Arbalest-Rocketry/flight-computer/__src__/apogee_detector/apogee/Screenshot (225).png

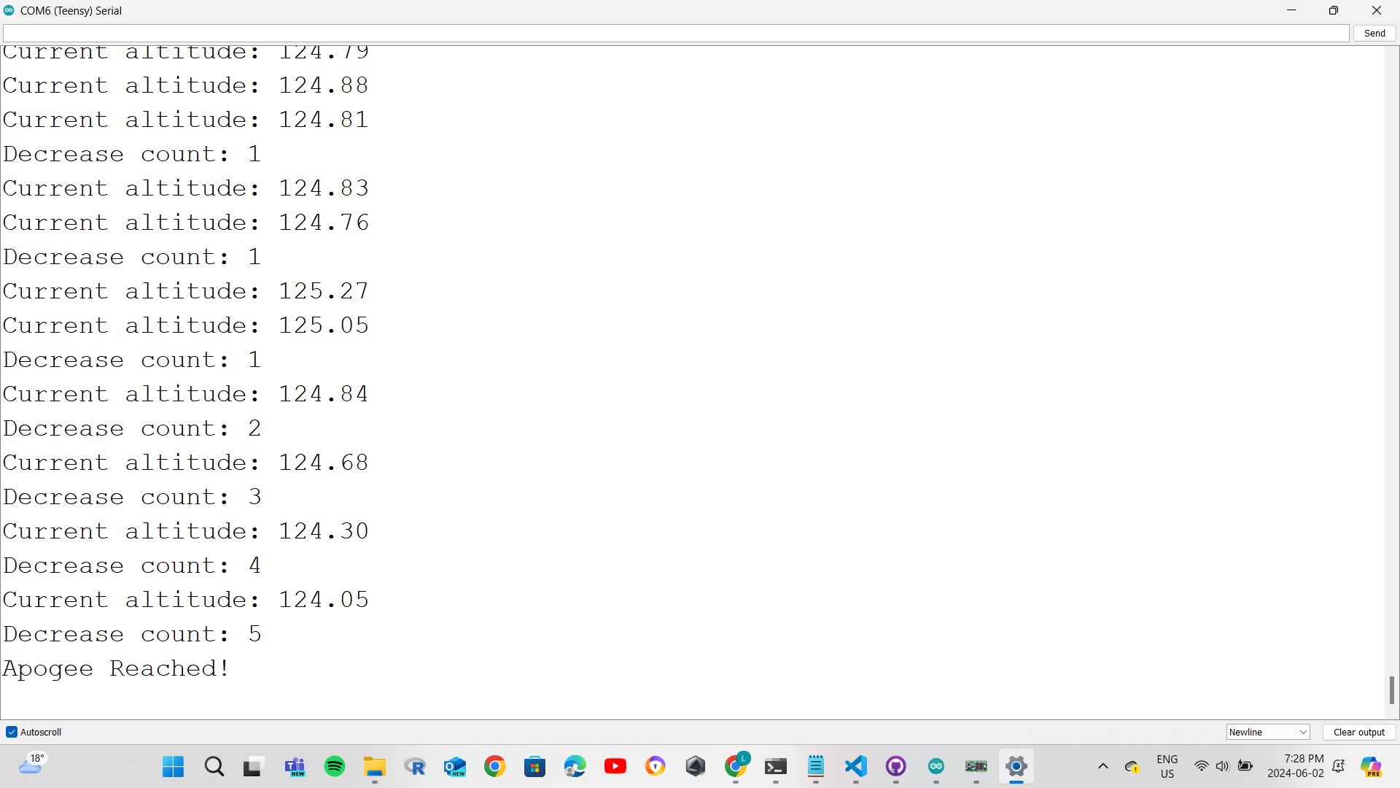
__src__/apogee_detector/apogee/Screenshot (225).png
