Arbalest-Rocketry/flight-computer/images/Electronics_mount_housing.png

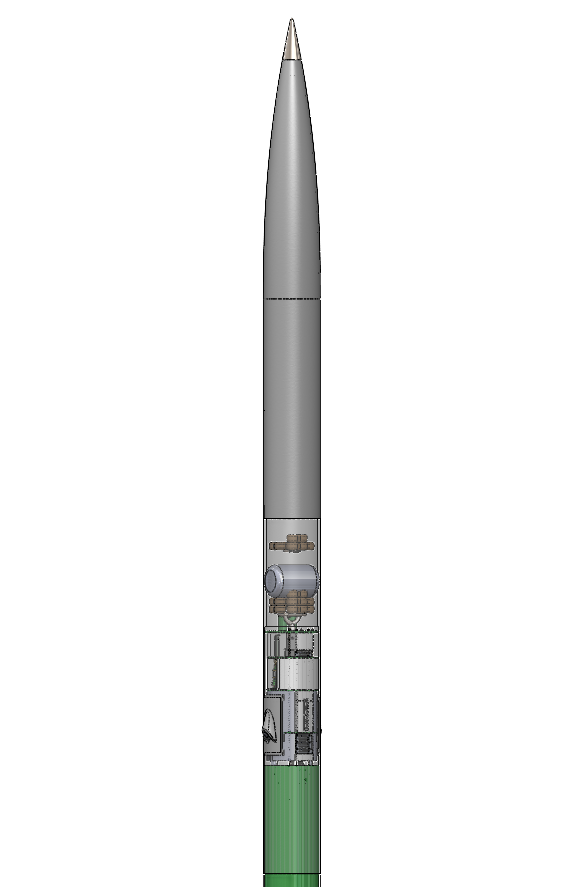
images/Electronics_mount_housing.png
