Arbalest-Rocketry/flight-computer/images/gems/20240319_135958.jpg

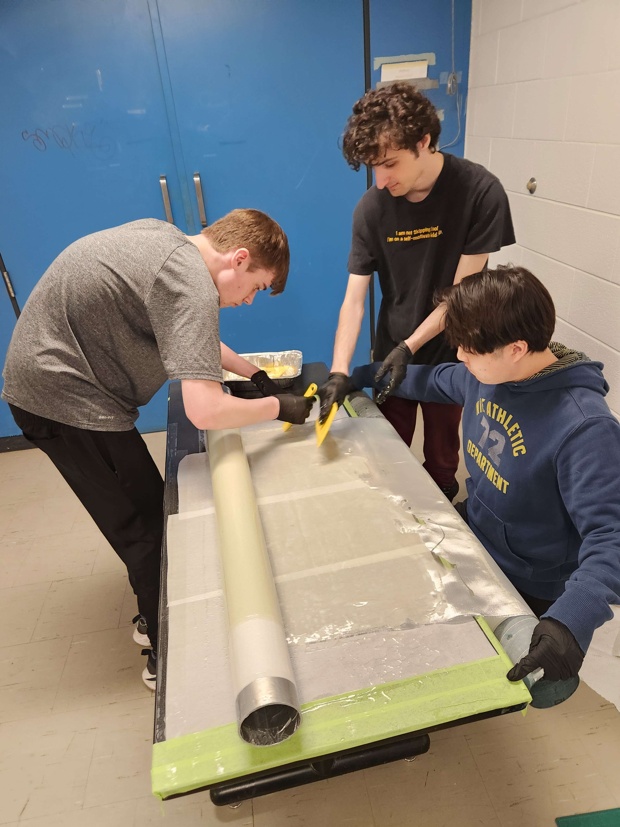
images/gems/20240319_135958.jpg
