Arbalest-Rocketry/flight-computer/images/gems/20240405_135742.jpg

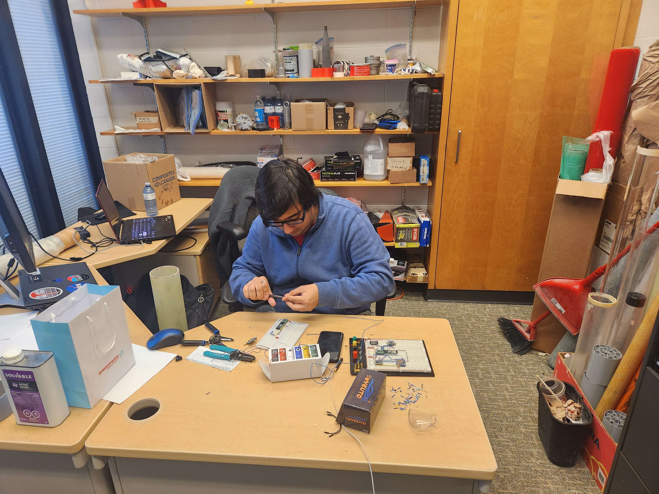
images/gems/20240405_135742.jpg
