Arbalest-Rocketry/flight-computer/images/gems/20240530_222145.jpg

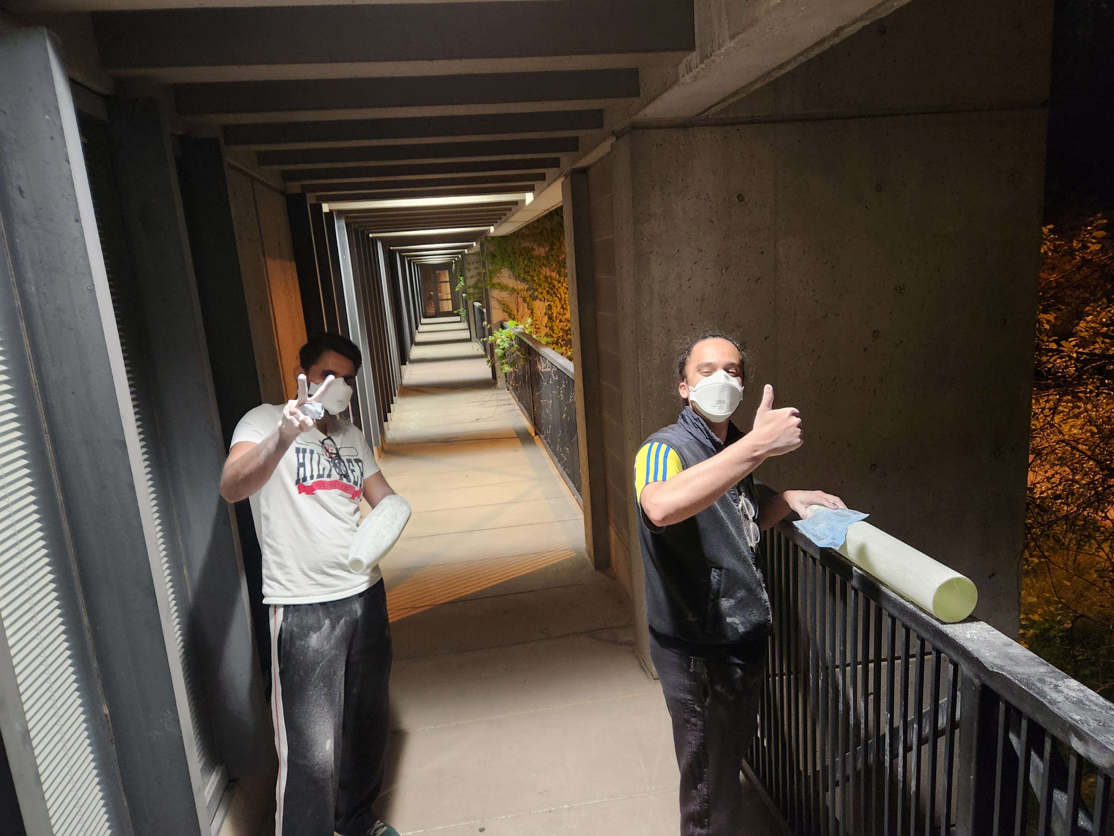
images/gems/20240530_222145.jpg
