Arbalest-Rocketry/flight-computer/images/gems/20240531_144227.jpg

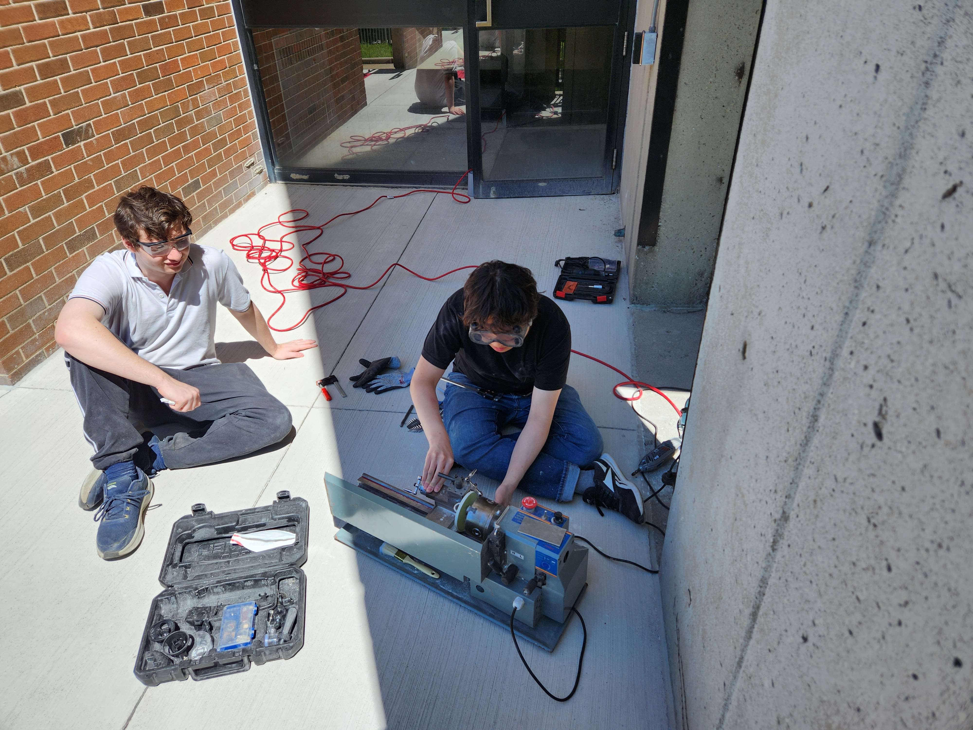
images/gems/20240531_144227.jpg
