Arbalest-Rocketry/flight-computer/images/gems/20240601_160821.jpg

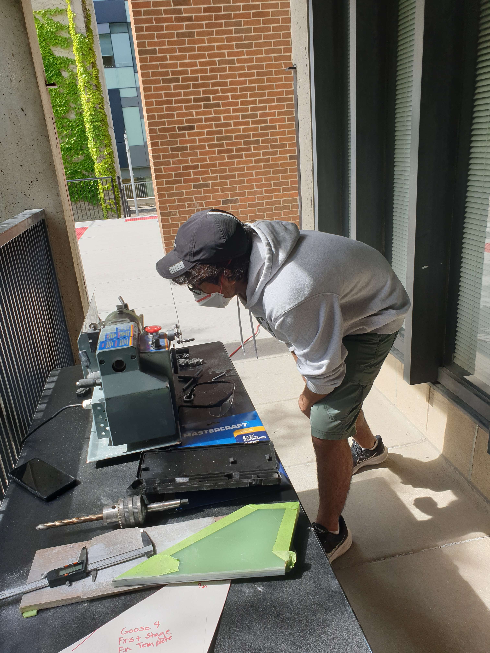
images/gems/20240601_160821.jpg
