Arbalest-Rocketry/flight-computer/images/gems/20240617_150155.jpg

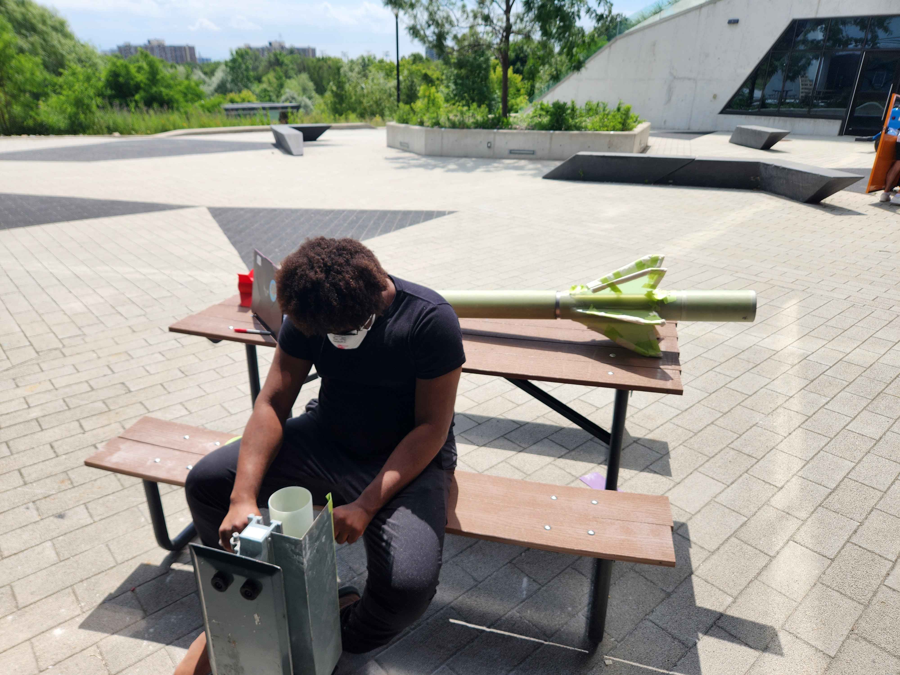
images/gems/20240617_150155.jpg
