Arbalest-Rocketry/flight-computer/images/gems/Caelan.jpg

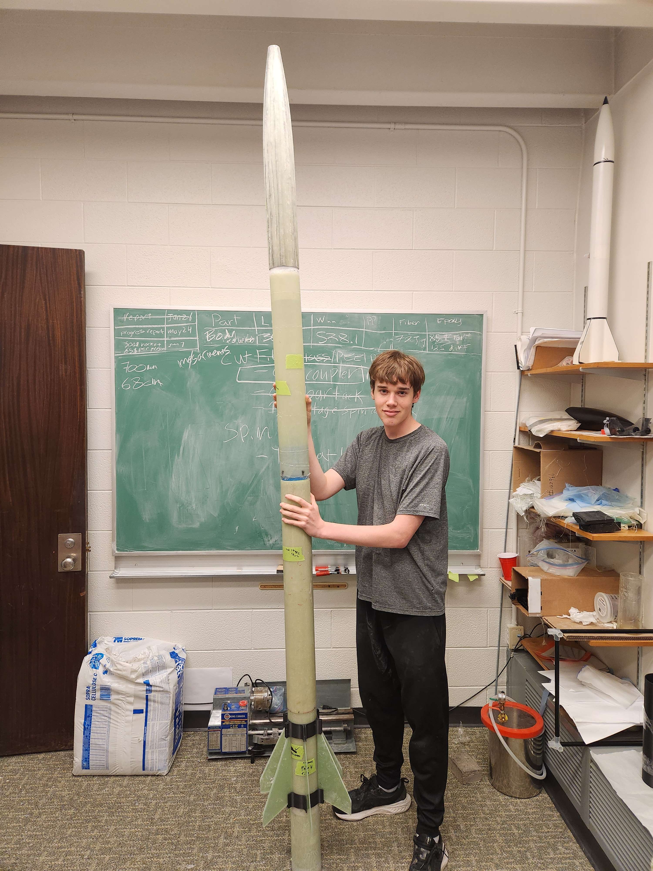
images/gems/Caelan.jpg
