Arbalest-Rocketry/flight-computer/images/gems/David_working_on_fins.jpg

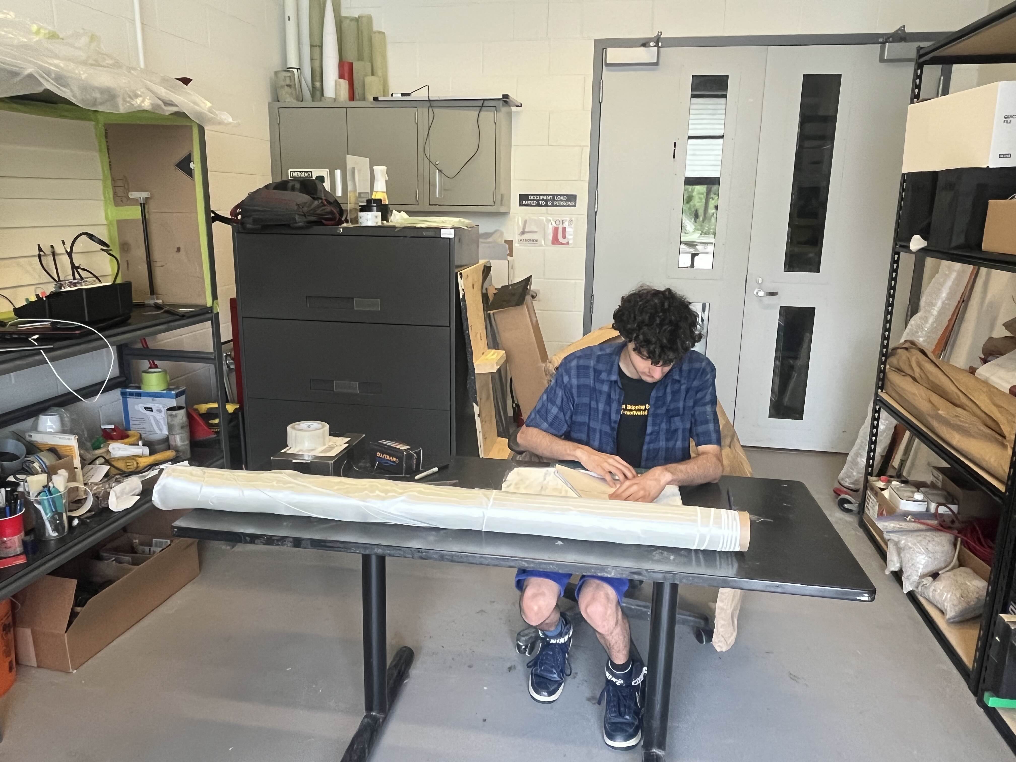
images/gems/David_working_on_fins.jpg
