Arbalest-Rocketry/flight-computer/images/gems/IMG_3216.jpg

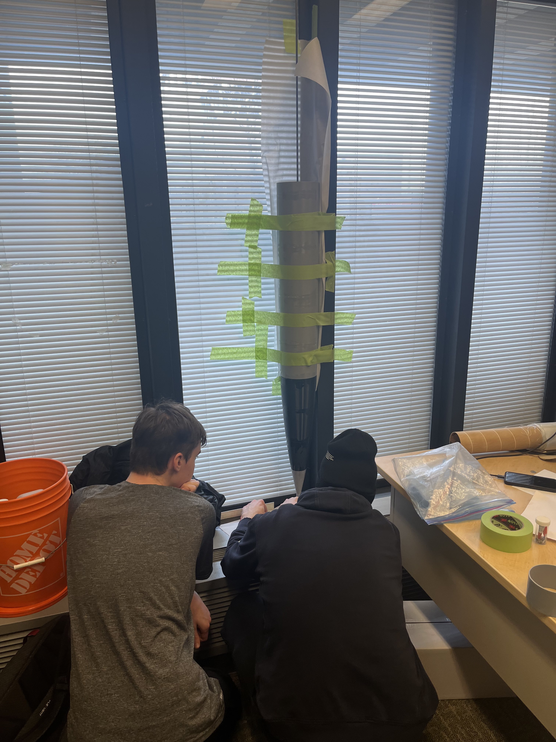
images/gems/IMG_3216.jpg
