Arbalest-Rocketry/flight-computer/images/gems/IMG_5076.jpg

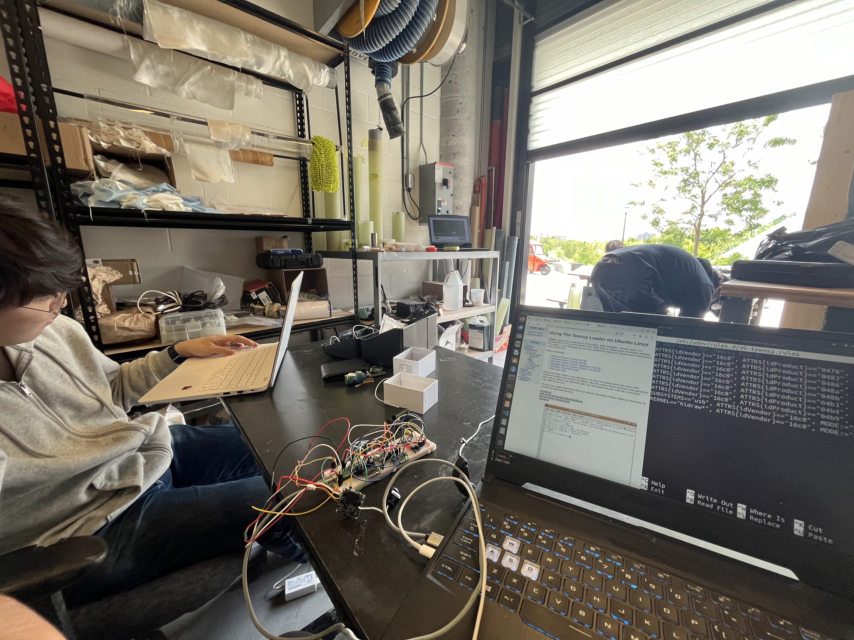
images/gems/IMG_5076.jpg
