Arbalest-Rocketry/flight-computer/images/gems/IMG_5404.jpg

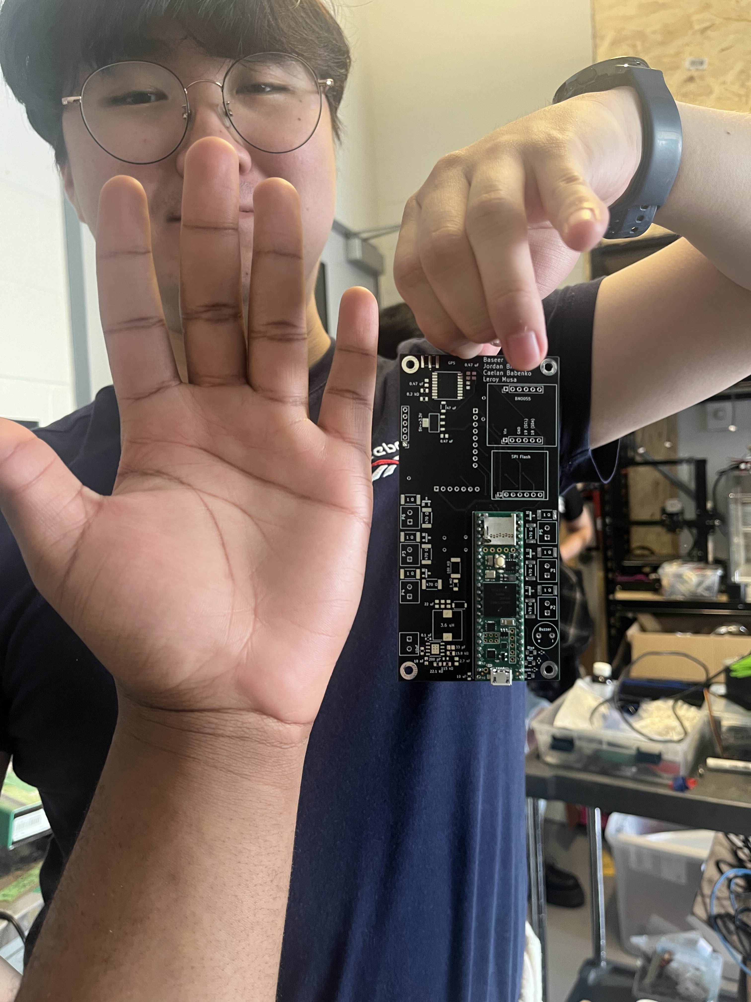
images/gems/IMG_5404.jpg
