Arbalest-Rocketry/flight-computer/images/gems/IMG_5406.jpg

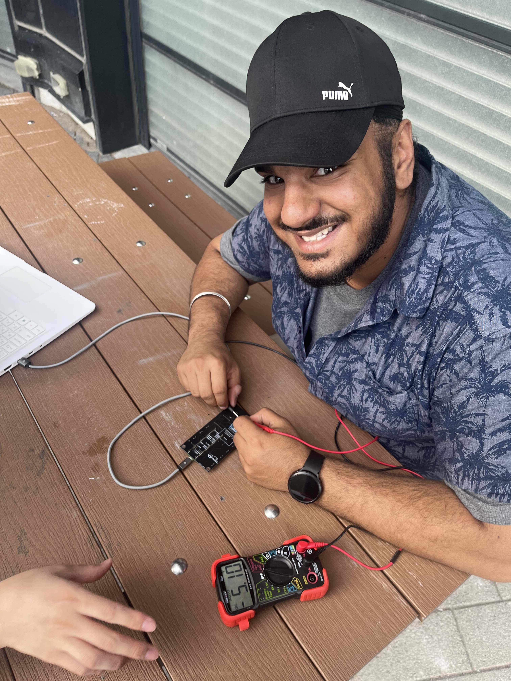
images/gems/IMG_5406.jpg
