Arbalest-Rocketry/flight-computer/images/gems/Jordan.jpg

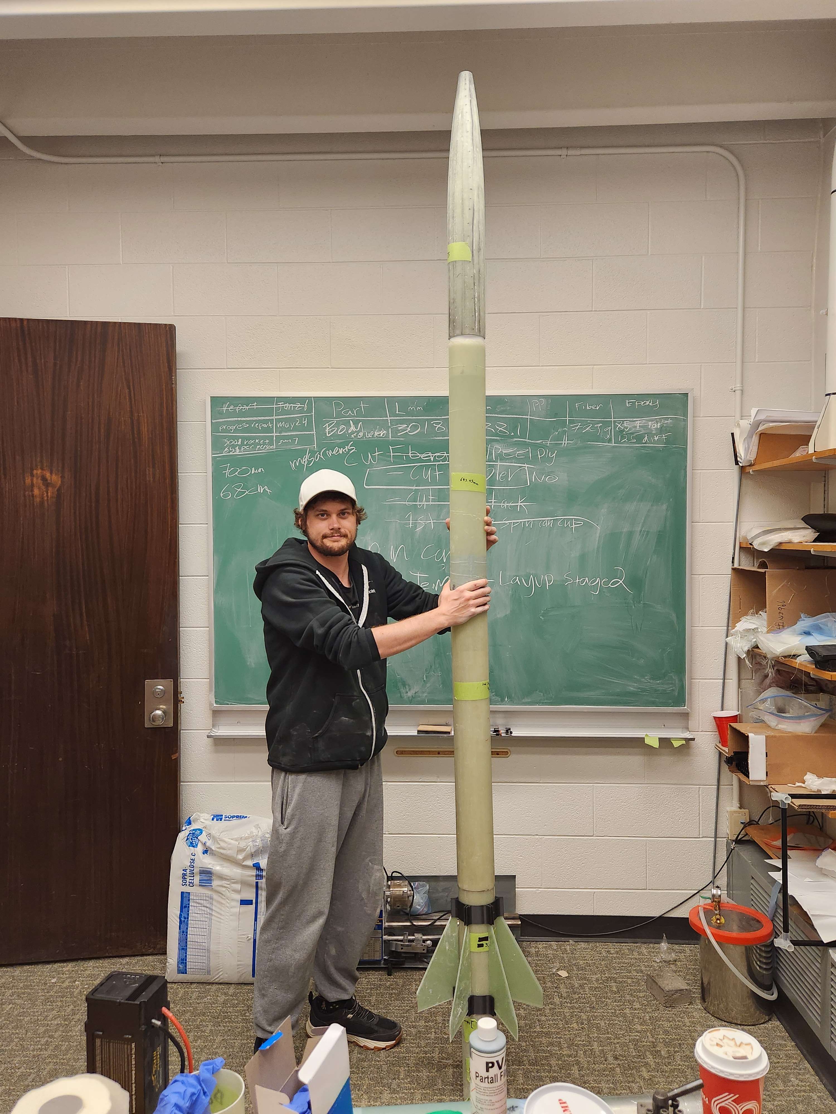
images/gems/Jordan.jpg
