Arbalest-Rocketry/flight-computer/images/gems/PXL_20240604_234544410.MP.jpg

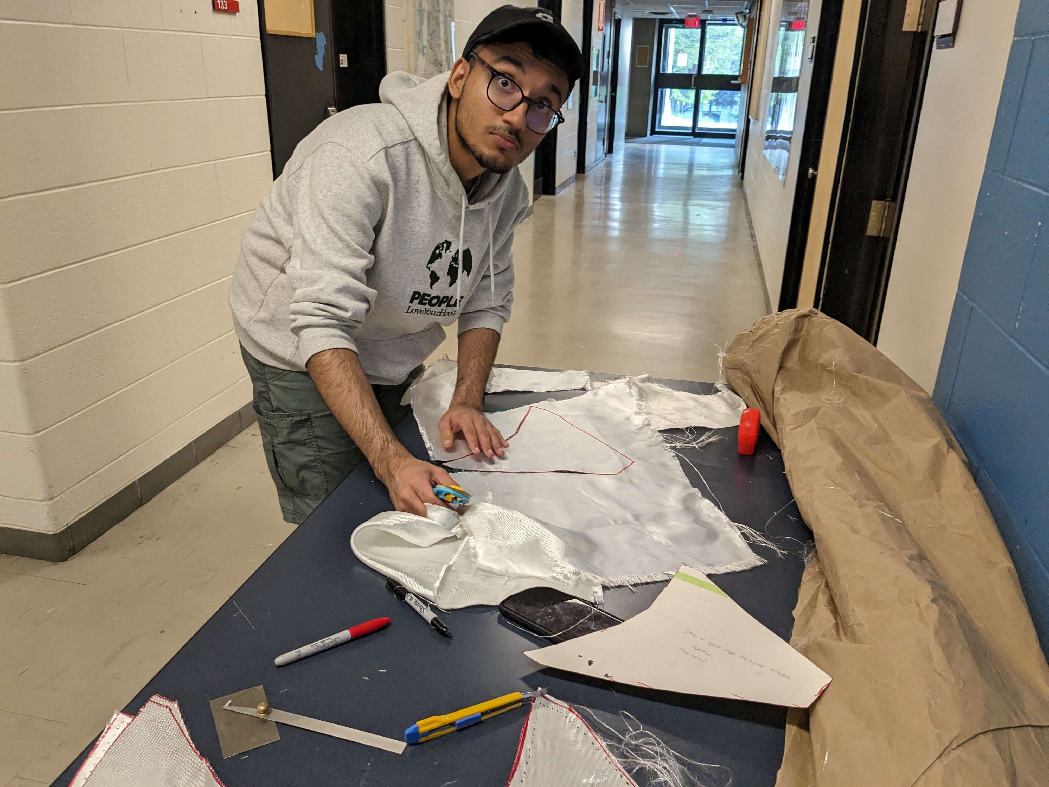
images/gems/PXL_20240604_234544410.MP.jpg
