Arbalest-Rocketry/flight-computer/images/IMG_4160.jpg

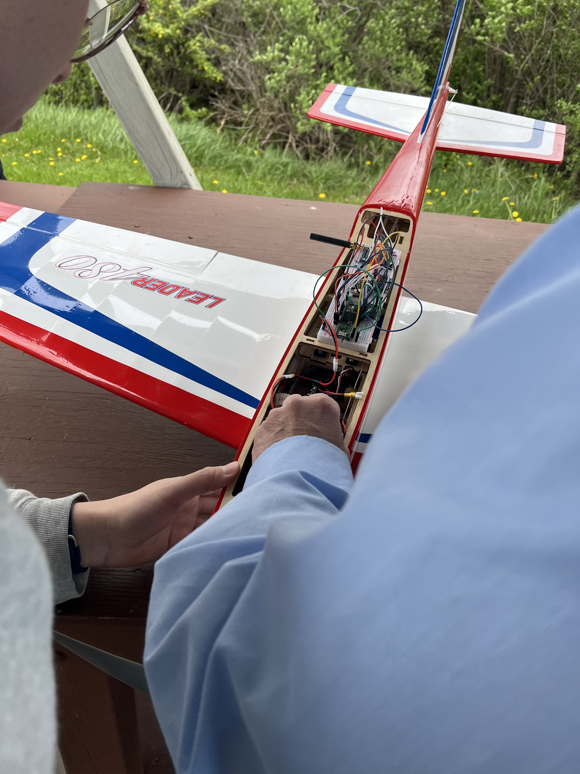
images/IMG_4160.jpg
