Arbalest-Rocketry/flight-computer/images/IMG_4161.jpg

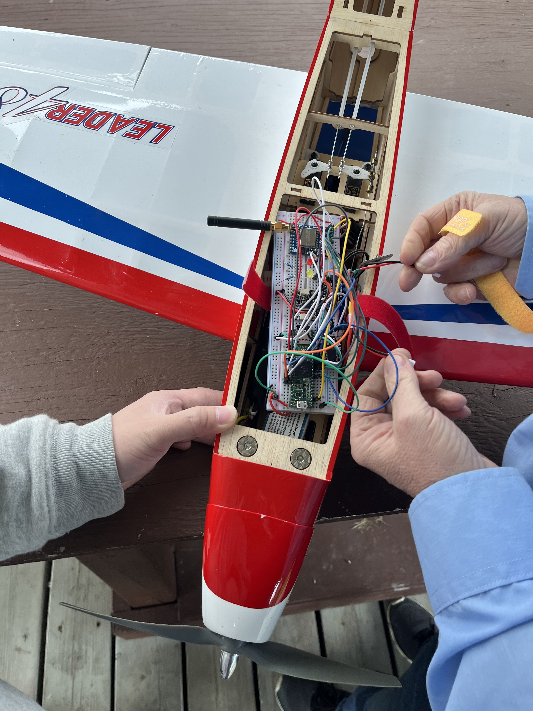
images/IMG_4161.jpg
