Arbalest-Rocketry/flight-computer/images/IMG_4163.jpg

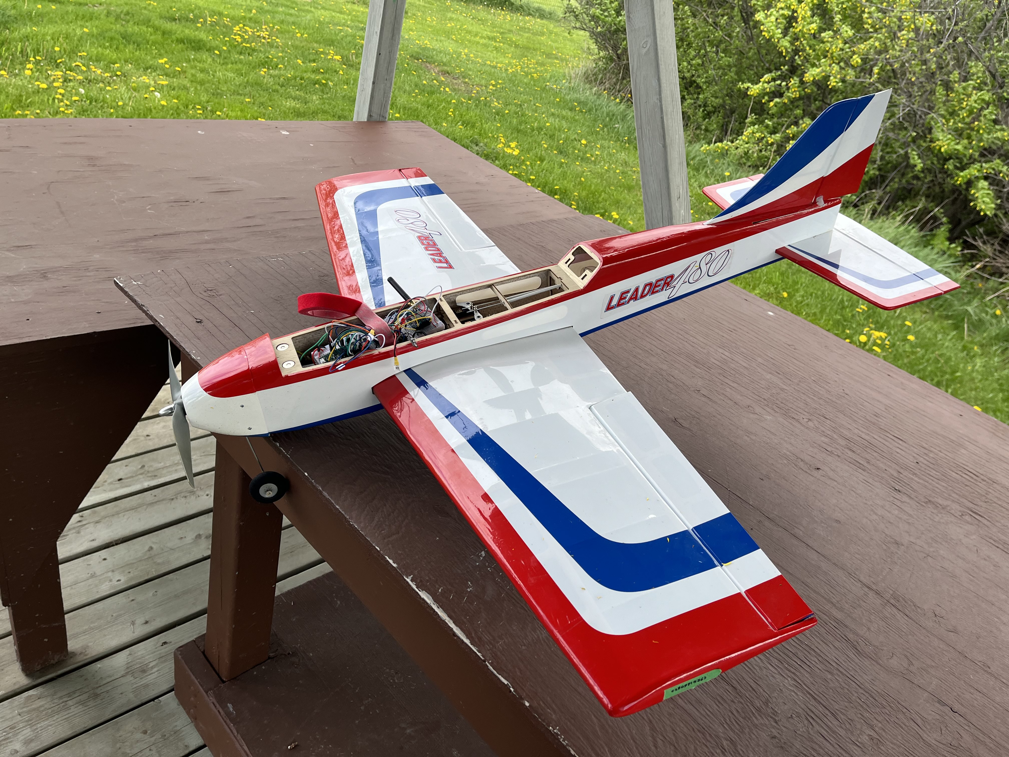
images/IMG_4163.jpg
