Arbalest-Rocketry/flight-computer/images/Nosecone_Tube.jpg

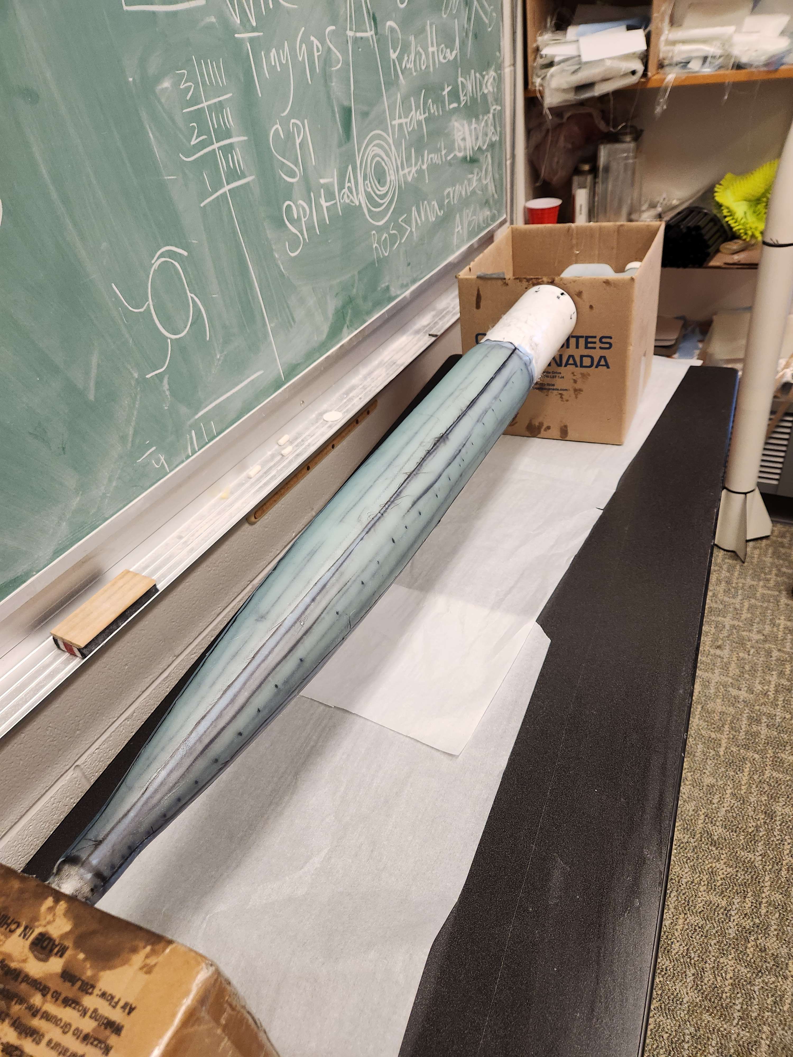
images/Nosecone_Tube.jpg
