Arbalest-Rocketry/flight-computer/images/onebreadboard.jpg

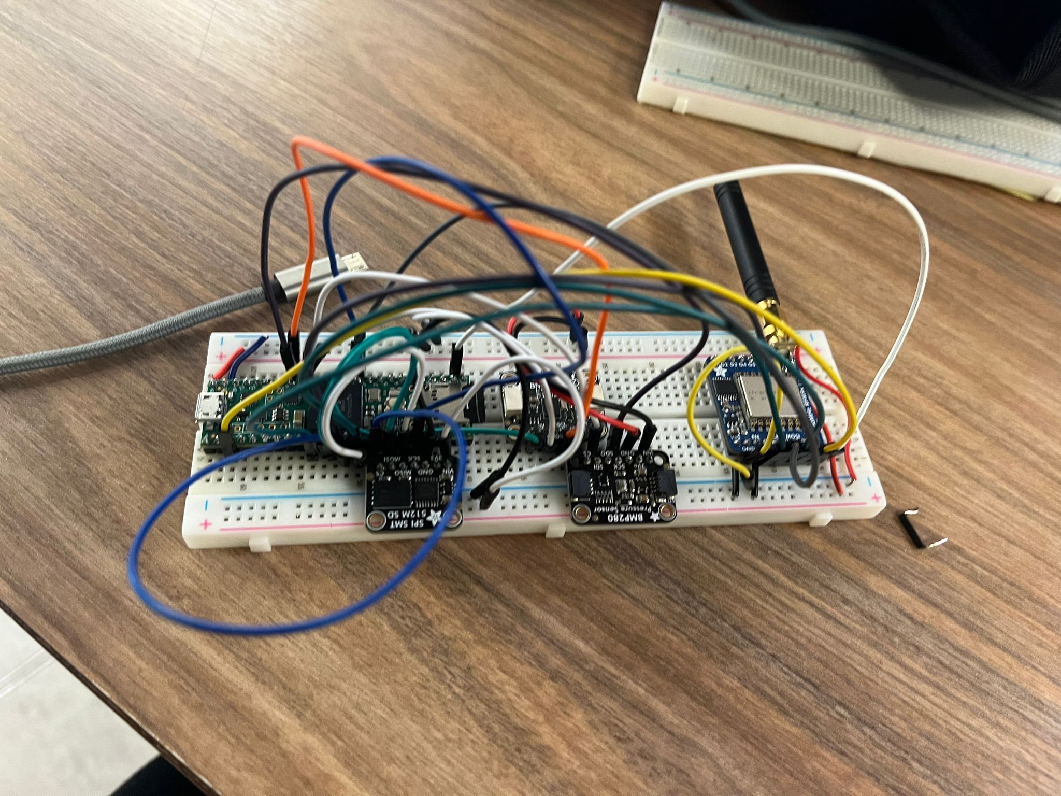
images/onebreadboard.jpg
