Arbalest-Rocketry/flight-computer/(threads)

Thread 2 (2024-06-03):

Bug: Error Handling for Sensor Initialization

leroymusa, 2024-06-03:
Implement robust error handling mechanisms for sensor initialization to handle cases where sensors are not detected or fail to initialize.

Closed 2024-07-09.
