Arbalest-Rocketry/flight-computer/schematics/pcb/FlightComputer.kicad_pcb

## KiCad design schematics/pcb/FlightComputer.kicad_pcb (2024-06-02)

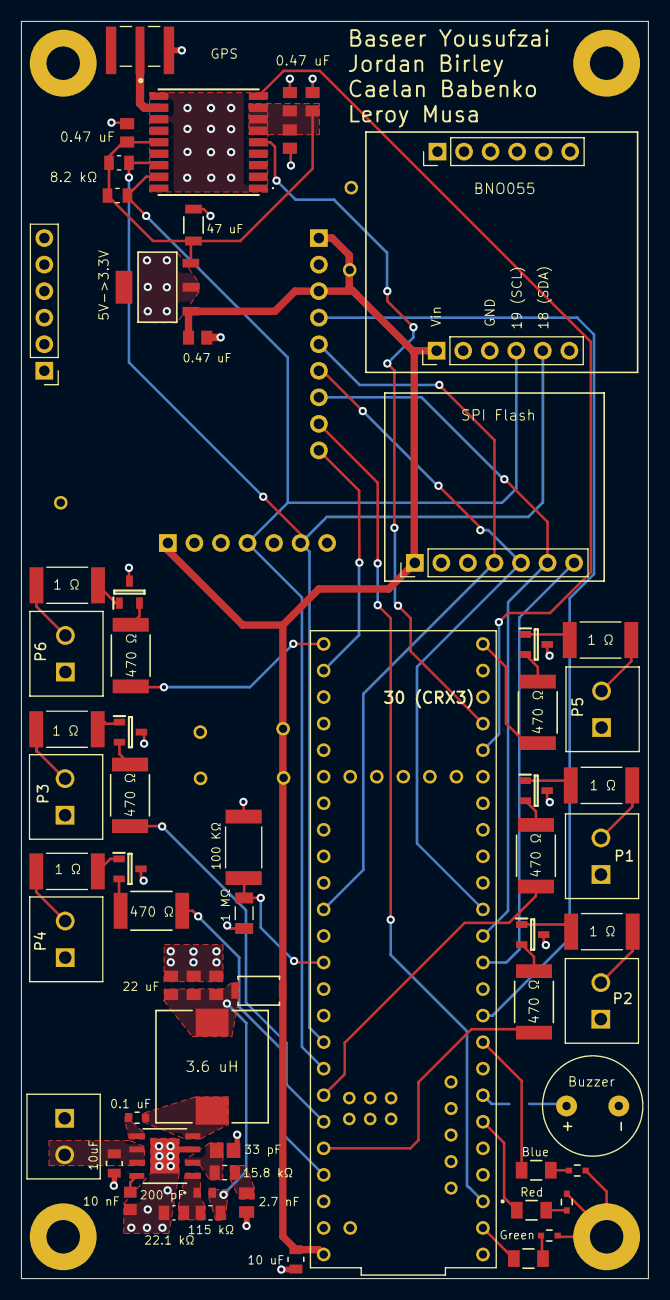
[picture p59: board FlightComputer.kicad_pcb from above]

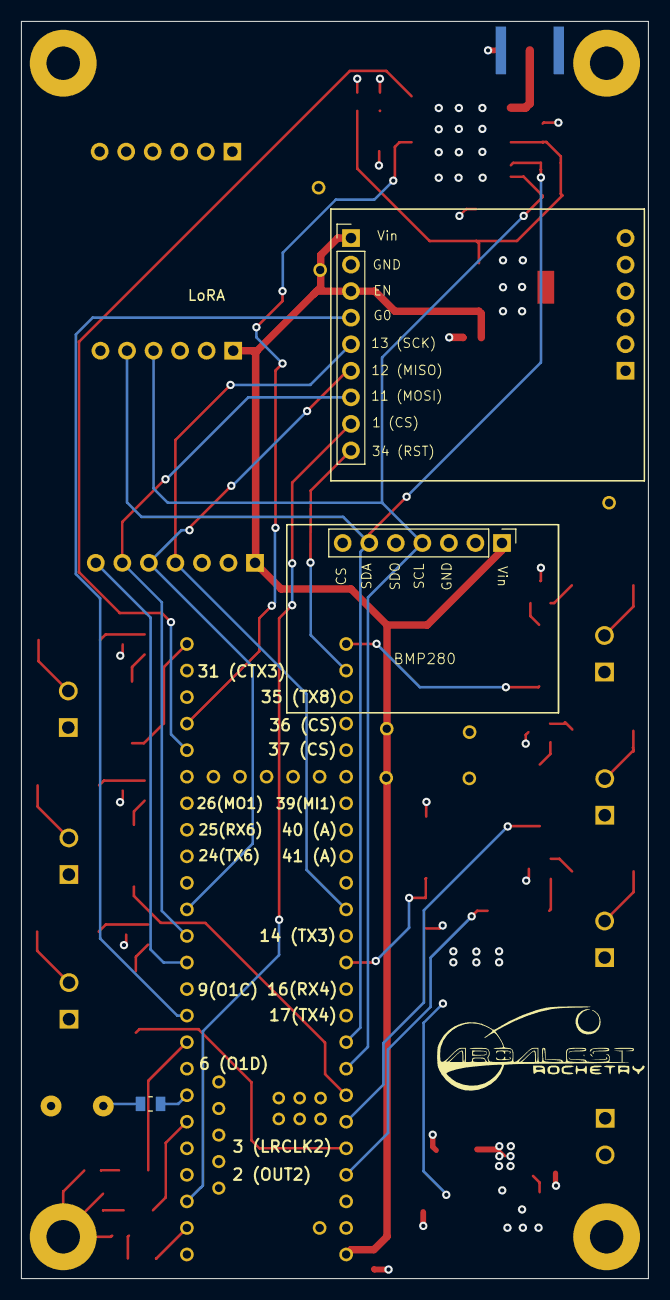
[picture p60: board FlightComputer.kicad_pcb from below]

Board: 4 copper layers, 60.0 x 120.3 mm, 73 parts (3 on the bottom side), 57 nets.

Parts:
3.6 uH: 3.6 uH; IND_1064_WE-PDF_WRE
BMP280: PinHeader_1x07_P2.54mm_Vertical
BNO055, BNO085, BNO085#2: PinHeader_1x06_P2.54mm_Vertical
Buzzer: CMI-9605IC-0580T; CUI_CMI-9605IC-0580T
C1: 10uF; CAP_CL21_SAM
C2: 22 uF (Each); CAP_CL_21_SAM
C3, C4: 22 uF; CAP_CL_21_SAM
C5: 10 uF; CAP_CL21_SAM
C7: 47 uF; CAP_CL31_SAM
C8: 33 pF; CAPC220145_88N_KEM
C9: 2.7 nF; CAP_CC0805_YAG
C10, C11, C12, C13, C17: 0.47 uF; CAP_CL_21_SAM
C14: 10 nF; CC0805N_YAG
C15: 0.1 uF; CAP_CL10_SAM
C16: 200 pF; CAP_06033D104JAT2A
H1, H2, H3, H4: MountingHole_Pad; MountingHole_3.2mm_M3_Pad
IC1: MAX-M10S-00B; MAXM10S00B
J1: SMA; TAOGLAS_EMPCB.SMAFSTJ.B.HT
LED1: Red; LED_XZCDG-8VF_SLD
LED2: Green; LED_XZCDG-8VF_SLD
LED4: Blue; LED_XZCDG-8VF_SLD
LoRA: PinHeader_1x09_P2.54mm_Vertical
P1, P2, P3, P4, P5, P6, P7: 1x2 Screw Terminal; OST_OSTTE020104
Q1, Q2, Q3, Q4, Q5, Q6: DMN3051L-7; SOT96P240X110-3N
R1: 1 MΩ; RESC3115X65N
R2: 15.8 kΩ; RESC2012X60N
R3: 22.1 kΩ; RESC2012X65N
R4: 100 KΩ; RESC6332X70N
R5: 324 Ω; RC1206N_VIS
R6, R7: 750 Ω; RC1206N_YAG
R8, R11, R13, R15, R17, R19: 1 Ω; RESC6332X70N
R9, R10, R12, R14, R16, R18: 470 Ω; RES_RMCF2512_STP
R20: 8.2 kΩ; RESC2012X60N
R21: 8.2k Ohm; RESC2012X60N
R22, R22#2: 115 kΩ; RESC2012X60N
R23: Diode; DIO_RB050LAM_ROM
SPI Flash: PinHeader_1x07_P2.54mm_Vertical
U1: Baseer Yousufzai; MODULE_DEV-16771
U2: 5V->3.3V; MP04A
U3: 7.5 V -> 5 V, 5 A; SO-8EP_DIO

Connections:
+3.3V: C7.2, C10.2, C11.2, C12.2, C13.2, IC1.6 (V_BCKP), IC1.7 (V_IO), IC1.8 (VCC), IC1.14 (VCC_RF), R20.2, R21.2, U2.3 (OUT)
+5V: BMP280.1, BNO055.1, C5.2, C17.1, LoRA.1 (VIN), LoRA.3 (EN), R23.1, SPI Flash.1, U1.VIN, U2.1 (IN)
+7.5V: C1.2, P1.1, P2.1, P3.1, P4.1, P5.1, P6.1, P7.2, R1.1, U3.2 (VIN), U3.3 (EN)
/FB: C16.1, R3.2, R22.1, U3.5 (FB)
/Pin 1 (CS): LoRA.8 (CS), U1.1 (TX1)
/Pin 5: Buzzer.P, R22#2.1, R22#2.2, U1.5 (IN2)
/Pin 8 (G0): LoRA.4 (G0), U1.8 (TX2)
/Pin 10 (CS): SPI Flash.7, U1.10 (CS1)
/Pin 11 (MOSI): LoRA.7 (MOSI), SPI Flash.6, U1.11 (MOSI)
/Pin 12 (MISO): LoRA.6 (MISO), SPI Flash.5, U1.12 (MISO)
/Pin 13 (SCK): LoRA.5 (SCK), SPI Flash.4, U1.13 (SCK)
/Pin 15 (A0): R1.2, R4.2, U1.15 (A1)
/Pin 18 (SDA): BMP280.6, BNO055.5, IC1.16 (SDA), R21.1, U1.18 (A4)
/Pin 19 (SCL): BMP280.4, BNO055.4, IC1.17 (SCL), R20.1, U1.19 (A5)
/Pin 20: R9.2, U1.20 (A6)
/Pin 21: R12.2, U1.21 (A7)
/Pin 22: R10.2, U1.22 (A8)
/Pin 23: R14.2, U1.23 (A9)
/Pin 28 (Reset): IC1.9 (RESET_N), U1.28 (RX7)
/Pin 29 (ExtInt): IC1.5 (EXTINT), U1.29 (TX7)
/Pin 32: R16.2, U1.32 (OUT1B)
/Pin 33: R18.2, U1.33 (MCLK2)
/Pin 34 (RST): LoRA.9 (RST), U1.34 (RX8)
/RF: IC1.11 (RF_IN), J1.1
GND: BMP280.3, BMP280.5, BNO055.3, Buzzer.N, C1.1, C2.1, C3.1, C4.1, C5.1, C7.1, C8.1, C9.1, C10.1, C11.1, C12.1, C13.1, C14.1, C17.2, H1.1, H2.1, H3.1, H4.1, IC1.1 (GND_1), IC1.10 (GND_2), IC1.12 (GND_3), J1.SH1, LED1.1, LED2.1, LED4.1, LoRA.2 (GND), P7.1, Q1.3 (D), Q2.3 (D), Q3.3 (D), Q4.3 (D), Q5.3 (D), Q6.3 (D), R3.1, R4.1, SPI Flash.3, U1.GND1 (GND), U1.GND2 (GND), U1.GND3 (GND), U1.GND4 (GND), U1.GND5 (GND), U2.2 (GND), U3.7 (GND), U3.EPAD (GND)
unnamed: C9.2, R2.1
unnamed: 3.6 uH.1, C2.2, C3.2, C4.2, C16.2, R22.2, R23.2
unnamed: LED1.2, R5.2
unnamed: LED2.2, R6.2
unnamed: LED4.2, R7.2
unnamed: P1.2, R8.2
unnamed: P2.2, R11.2
unnamed: P3.2, R13.2
unnamed: P4.2, R15.2
unnamed: P5.2, R17.2
unnamed: P6.2, R19.2
unnamed: Q1.1 (G), R8.1
unnamed: Q1.2 (S), R9.1
unnamed: Q2.1 (G), R11.1
unnamed: Q2.2 (S), R10.1
unnamed: Q3.1 (G), R13.1
unnamed: Q3.2 (S), R12.1
unnamed: Q4.1 (G), R15.1
unnamed: Q4.2 (S), R14.1
unnamed: Q5.1 (G), R17.1
unnamed: Q5.2 (S), R16.1
unnamed: Q6.1 (G), R19.1
unnamed: Q6.2 (S), R18.1
unnamed: U1.3.3V_1 (3.3V), U1.3.3V_2 (3.3V), U1.3.3V_3 (3.3V)
unnamed: R5.1, U1.4 (BCLK2)
unnamed: R6.1, U1.0 (RX1)
unnamed: R7.1, U1.7 (RX2)
unnamed: U1.USB_GND1 (USB_GND), U1.USB_GND2 (USB_GND)
unnamed: C15.1, U3.1 (BST)
unnamed: C8.2, R2.2, U3.6 (COMP)
unnamed: C14.2, U3.4 (SS)
unnamed: 3.6 uH.2, C15.2, U3.8 (SW)
