Arbalest-Rocketry/flight-computer/sensor_testing/lora/transciever_test/transciver/RADIO/radio_class.h

#pragma once
#include <Arduino.h>
#include <algorithm>
#include <RH_RF95.h>
#include <SerialTransfer.h>

#define RFM95_CS 1
#define RFM95_RST 34
#define RFM95_INT 8
#define RF95_FREQ 915.0

class Radio {
  private:
    RH_RF95 rf95;
    const static int dataPointCount = 27;
    float flightData[dataPointCount];
    char packet[dataPointCount*4];
    union floatunion_t;
    float decoder(char* encoded);
    SerialTransfer myReceive;
    char buf[dataPointCount*4];

  public:
    Radio() : rf95(RFM95_CS,RFM95_INT) { }
    void init();  
    void begin(); 
    void receivedPacket();  
    void readRadio(); 
    void sendRadio(char* buffer2);
    void decodeData();  
    void printData();
    void sendingPacket();
    char* readSerial();
};
