Arbalest-Rocketry/flight-computer/(commit log)

2024-06-02 tree_wide: Added sensor module datasheets
2024-06-03 apogee.cpp; efk.cpp: Implemented Extended Kalman Filter (EKF) using Eigen library for sensor fusion.
2024-06-03 flightcode_main.ino: Refactored code for concise integration of logic through .h files, resolving linker errors caused by redundant object declarations.
    [EKF.cpp, EKF.h, apogee.cpp, apogee.h, flightcode_main.ino]
2024-06-03 tree_wide: Added credits for PCB Design on README.md
2024-06-03 flightcode_main.ino: Added sequential rocket stage control logic from launch to landing and low power mode.
2024-06-04 flightcode_main.ino: Calculated Expected Response Values for Power On, Power Off, and Start Recording Actions on our RunCam Split 4
2024-06-04 tree_wide: Updated Camera Configuration Naming Convention
2024-06-12 refactor: Remove outdated CircuitPython binaries and add MicroPython folder
    - Deleted obsolete adafruit-circuitpython binaries (.hex and .uf2 files) from lib directory
    - Added a new MicroPython folder for RunCam integration
2024-06-12 feat: Add CircuitPython support for Teensy 4.1 integration
2024-06-18 refactor: added current working runcam implementation to flightcode_main.ino
2024-06-18 fix: Resolve multiple definition errors in variable declarations
    [apogee.h, flightcode_main.ino, rocket_stages.h]
2024-06-18 refactor: Delete __src__/circuitpython directory
2024-06-19 feat: modified altimeter kalman filter class - working
2024-06-20 feature: Add sensor initialization and calibration for BNO055
2024-06-20 fix: Integrate working EKF into flight computer, and enhance logging and transmission
    [EKF.cpp, EKF.h, flightcode_main.ino]
2024-06-23 feature: added buzzer song for flight computer start up
    [main.ino]
2024-06-24 fix: update dependencies for songs
    [flightcode_main.ino]
2024-06-26 add: Cleanup and add I2C scanner and IMU test code
